pierre-muth/fast-flipdot/README.md

# fast-flipdot
Driving a flipdot matrix differently. All dots simultaneously. 
story here : https://pierremuth.wordpress.com/2021/02/17/flipping-dots-fast/
video here : https://youtu.be/6l5hH8V9uUo

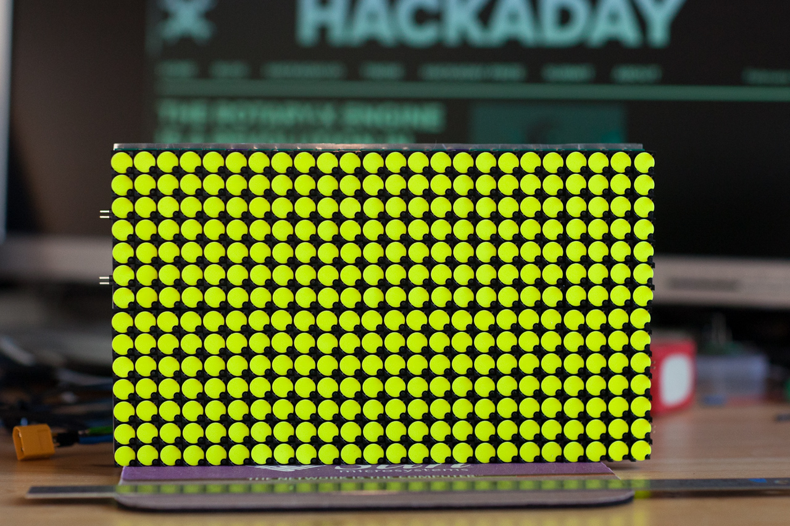
[picture p1: IMG_7713.jpg]
matrix
