pierre-muth/fast-flipdot/kicad/dot_flipper/dot.png

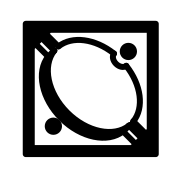
kicad/dot_flipper/dot.png
