pierre-muth/fast-flipdot/kicad/FlipDot-Mase.png

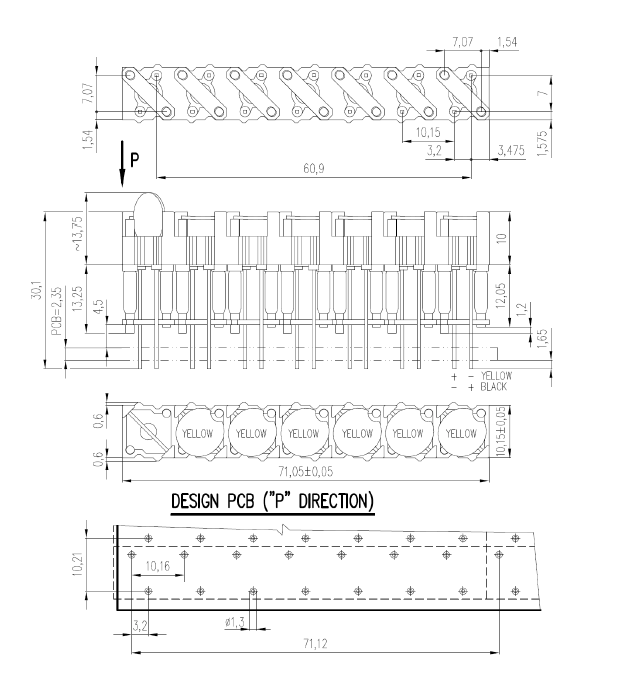
kicad/FlipDot-Mase.png
