pierre-muth/fast-flipdot/kicad/dot_flipper/dot_flipper.step

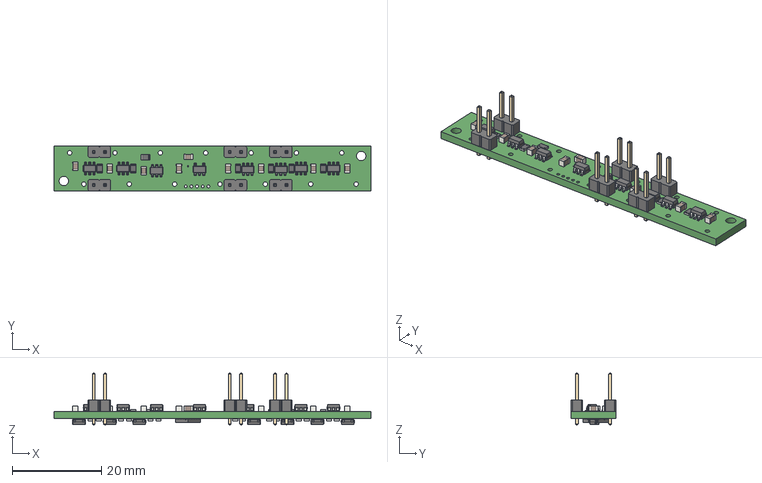
[picture p4: CAD file, 2021-02-18]
kicad/dot_flipper/dot_flipper.step
71.0 x 10.0 x 11.5 mm
