pierre-muth/fast-flipdot/(threads)

Thread 1 (2021-02-22):

Where to place the free-wheel diode ?

anybuche, 2021-02-22:
Hi,

I'm interested to push your design further, I see the used regulator can handle -20V to +38V so I guess it is already the more robust one. However it is unclear to me where you placed the free-wheel diode ? I would put it once per board between GND and 12V but wanted to ask for confirmation.

Thanks for your help

pierre-muth, 2021-02-22:
Hi !
Sorry it was unclear.
Yes, the microchip regulator is the more robust one, I didn't have any problem any more.
I only place one reverse diode between the main power connection. Not on all the boards. Apparently it is sufficient to absorb a negative pulse, which rarely appears when I disconnect the battery. Anyway the new regulators can handle it.
Sorry for the markings as well. It barely work with 12V, prefer at least 16V. In my setup I used a 4S lipo, but it's ideally 24V.
It is good you're asking questions, I realize I forgot quite some info.
For example, the capacitors should have the lowest resistance possible. Keep the 1210 package, as the 0805 will not work. Also, I stacked 2x 10uF for this reason.
I'm looking forward to see your design ! I'm sure mine can be greatly enhanced.
Anyway, don't hesitate!

Thread 2 (2021-11-06):

Two small schematic questions

dot4qu, 2021-11-06:
Hi Pierre,

Great design. I have a couple questions that I think are obvious but I want to double check
This is a screenshot of the basic components for each flip dot
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

1. Why have a second N-channel FET in front of the P-channel FET for FLIP_A_ON? Is it because you don't want to sink any current at that GPIO when the the pin is low? I ask because 12V / 100k = ~120uA and I'd assume the GPIO can sink in the 10s of mA no? I agree your design is more robust, but just a thought based on part count.
2. Any specific reason why you're using two separate pins for off and on instead of one and inverting the logic? Something like this:
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

pierre-muth, 2021-11-06:
Hi Brian,
Thanks for the questions and ideas!
The 12v potential on the schematics should be between 16 to 20v to have a better flipping. 12V works but is the lower limit.
I think I cannot sink 16v to ground with the PIC microcontroller.
In your schematics, R3 should be rather high to not blow Q2. This will prevent rapid discharge of C1 if I'm not wrong. In order to have the disc flipping, a high current should be able to flow through the coil, in both directions. The aim is to magnetize the core in one way or an other. So we have to maximize the current that charge the capacitor to flip in one way, and also maximize the discharge current to flip the other way.
Having two separate pins for ON and OFF (or flip one way, flip the other way) also makes possible to have a low consumption rest state.
Hope that make sense. Of course I'm sure I didn't make the more efficient design. It would be nice to reduce the parts count, but it was not my purpose. Commercial flipdot driver boards use source/sink matrices, and they are quite efficient.
Have a nice day, and don't hesitate,
pierre

dot4qu, 2021-11-12:
Isn't Q2 similar to Q1A in your schematic though? And your Q1A is shorted straight to ground so that's going to have a higher current across than Q2 would with R3 in series. So if Q1A works with the current of a full capacitor discharge to ground, I'd imagine a similar part could handle the current created from R3 when when Q2 is turned on to charge the capacitor. Am I understanding that correctly?

Otherwise yes, I totally understand that it only saves a single FET on the BOM which at these quantities is basically pointless. I'm just trying to better understand if what I have is equivalent in function.

pierre-muth, 2021-11-12:
To flip the disc to a position, a current has to flow few milliseconds through the coil, in order to magnetize the core in one direction.
If I'm following correctly your schematic, a signal on FLIP_A that goes from 0 to 5v will charge the capacitor, and flip the disc from back to yellow. Then, if FLIP_A goes back from 5v to 0v, the capacitor is discharged, and the disc flip back from yellow to black.
For the discharge to be efficient, R3 should be low. Is to keep the disc on the yellow side, current should constantly flow through R3? If you multiply this by 100's of disc, it will be a lot of current.
I could wrong of course. I made a lot of tests with one disc and a breadboard. Maybe you can try different strategies as well, I'm very interested in a solution uses less gpio and parts!

dot4qu, 2021-11-13:
Yes, all completely correct. I was making the mistake of forgetting that the whole point of flip-dots is to flip a hole bunch of them! You're right, it would burn current while Q2 stayed on after charging the capacitor and I completely forgot to multiply that by a large amount of dots. So for now it seems like your circuit definitely is the correct way to go. Thanks for the quick responses!

Closed 2021-11-13.

Thread 5 (2023-03-31):

Simulation : current on discharge

seigel, 2023-03-31:
I’m staring at the design, and I know from watching the breakfast vids that it works but I don’t understand how the current flows through the coil(inductor) when the charged side of the cap is connected to Gnd.  Anyone know of a spice or other sim I could watch or play with. Or if someone could dumb it down for me. :)
