pierre-muth/fast-flipdot/kicad/dot_flipper/Untitled.pdf

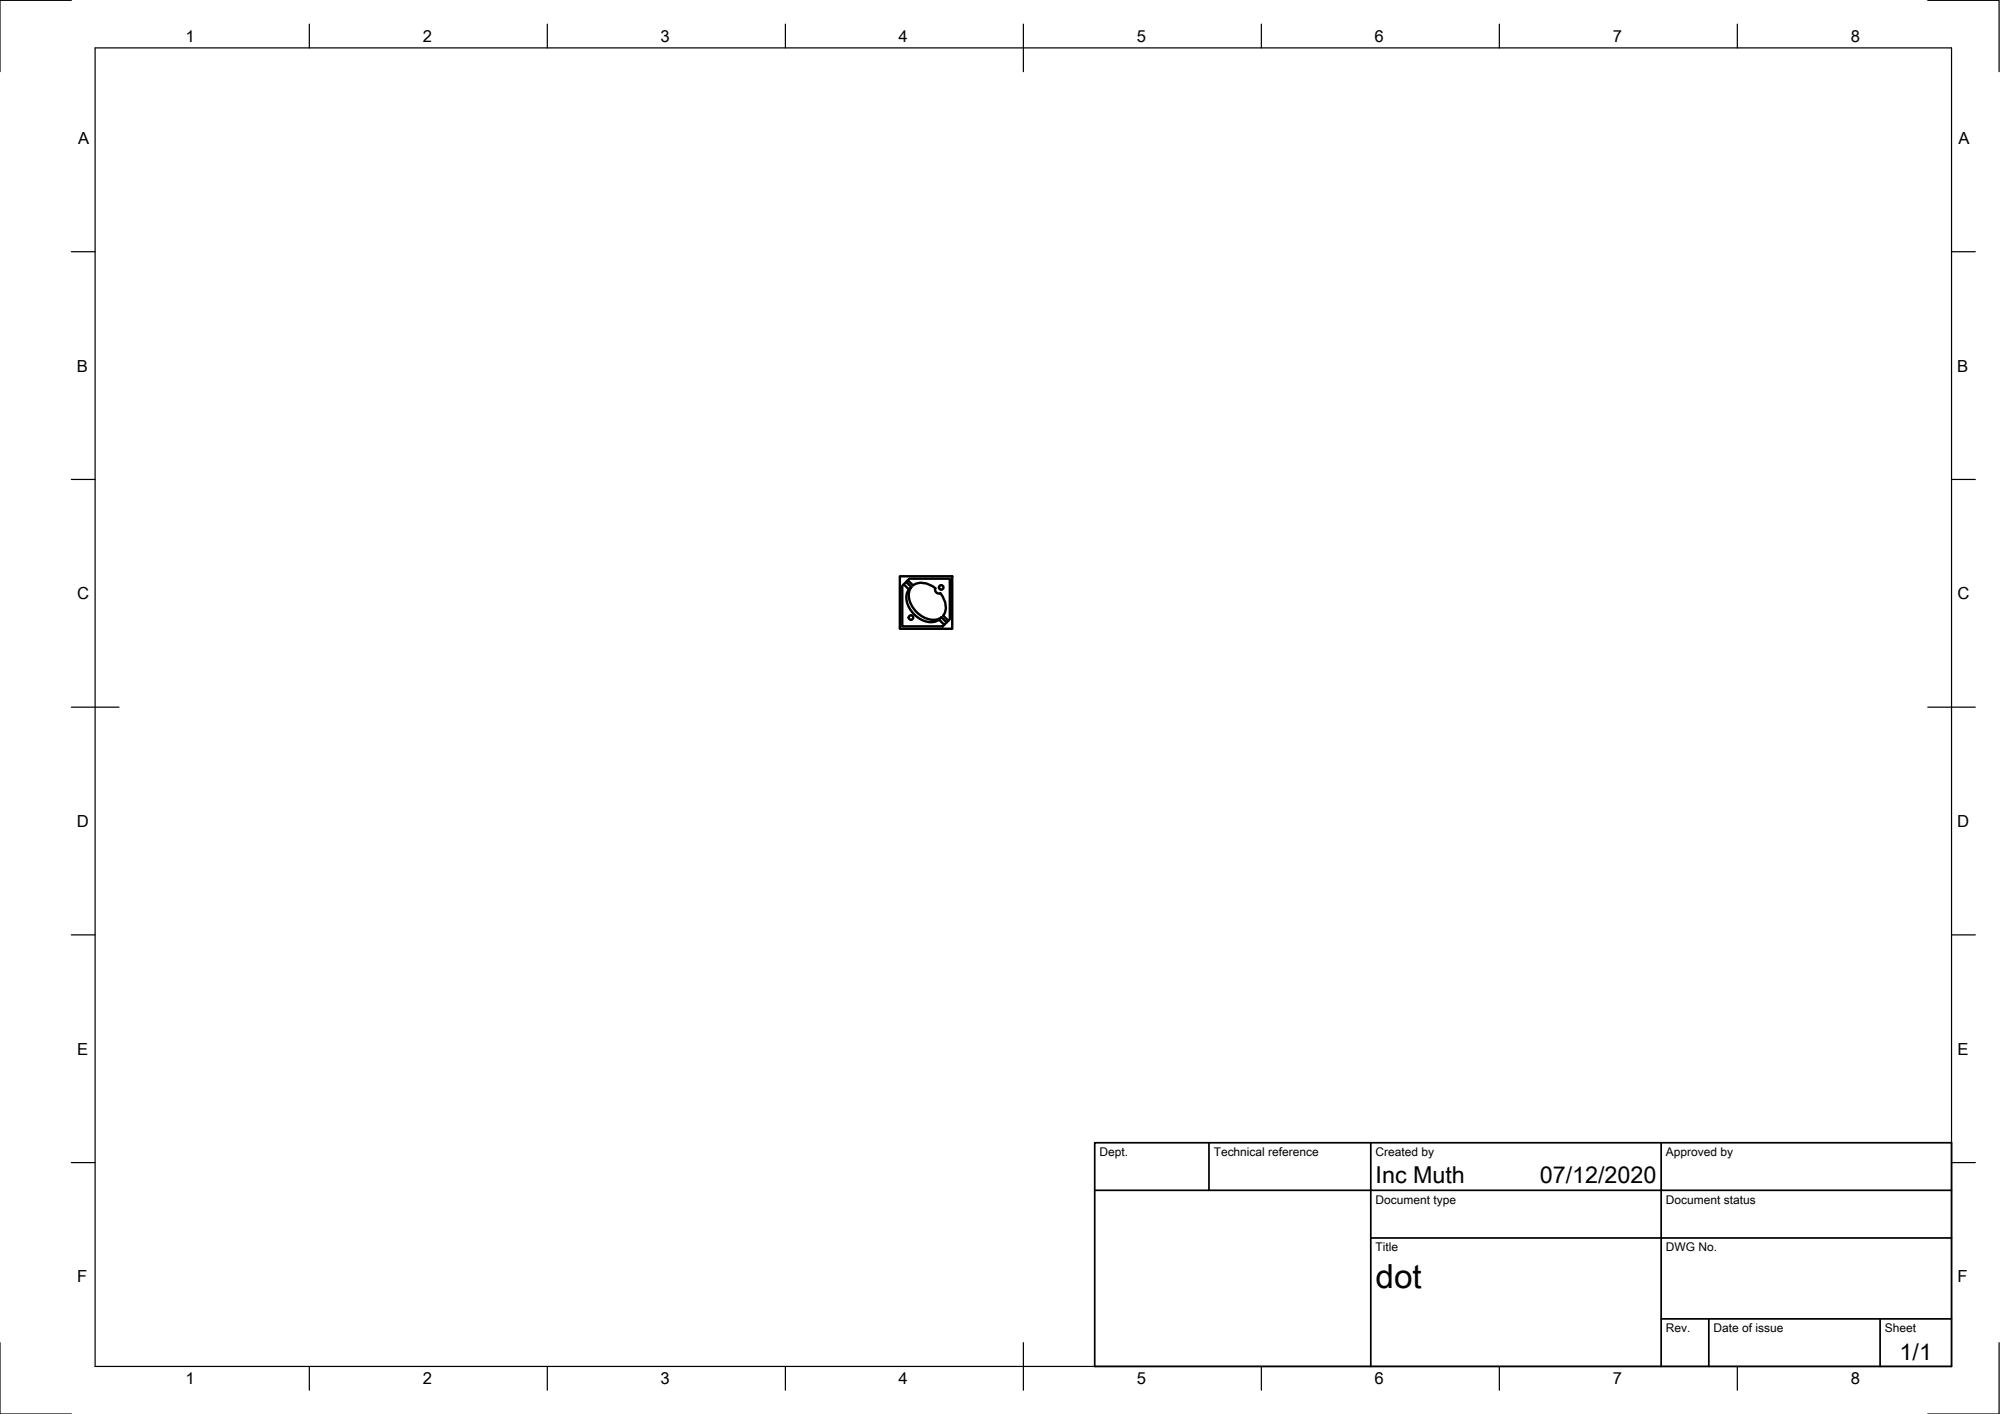
[picture p5: page 1]

Dept. | Technical reference | Created by Inc Muth 07/12/2020 | Approved by

Document type | Document status

Title dot | DWG No.

Rev. | Date of issue | Sheet 1/1
