pierre-muth/fast-flipdot/kicad/dot_flipper/pdf/dot_flipper-B_Cu.pdf

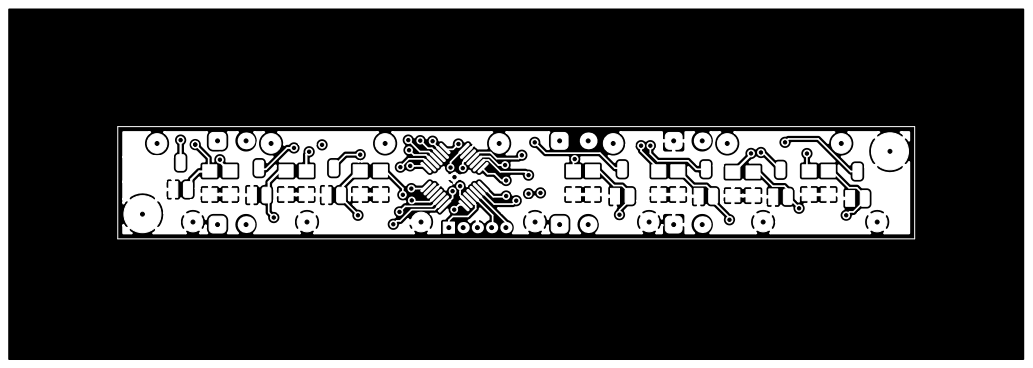
[picture p6: page 1]
