pierre-muth/fast-flipdot/kicad/dot_flipper/pdf/dot_flipper-F_Cu.pdf

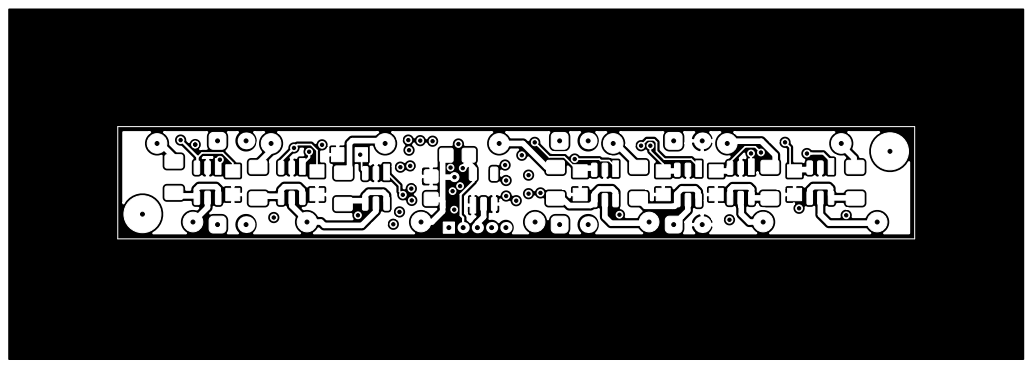
[picture p7: page 1]
