pierre-muth/fast-flipdot/kicad/dot_flipper/pdf/dot_flipper-In1_Cu.pdf

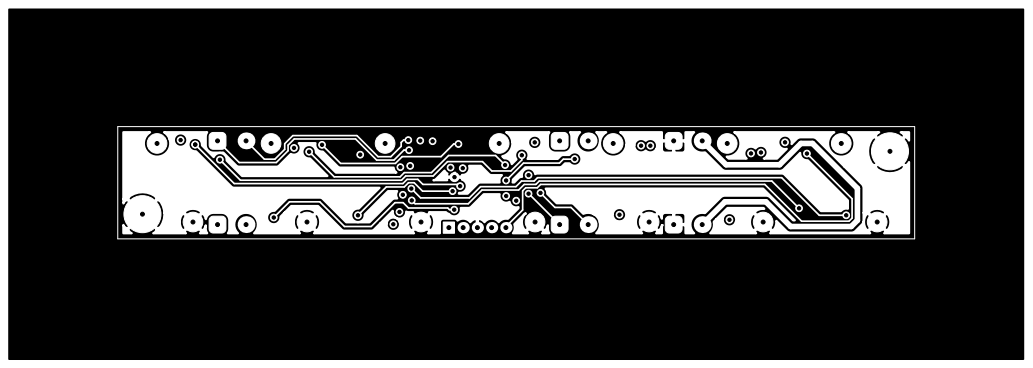
[picture p8: page 1]
