pierre-muth/fast-flipdot/kicad/dot_flipper/pdf/dot_flipper-In2_Cu.pdf

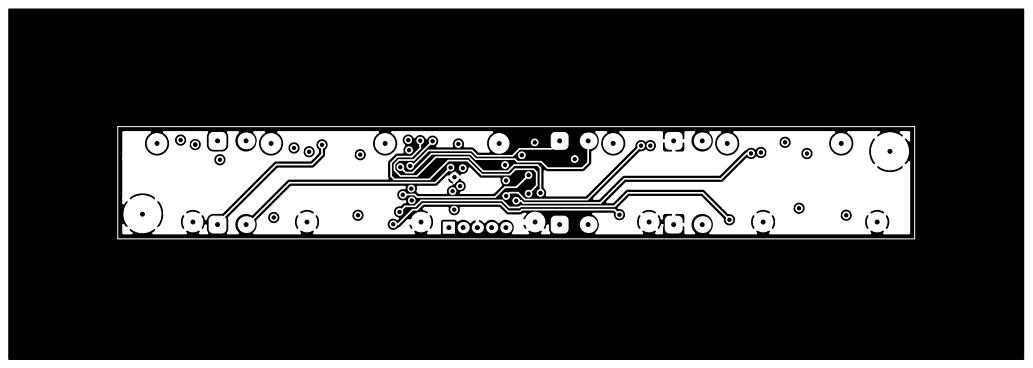
[picture p9: page 1]
