pierre-muth/fast-flipdot/kicad/dot_flipper/pdf/dot_flipper.pdf

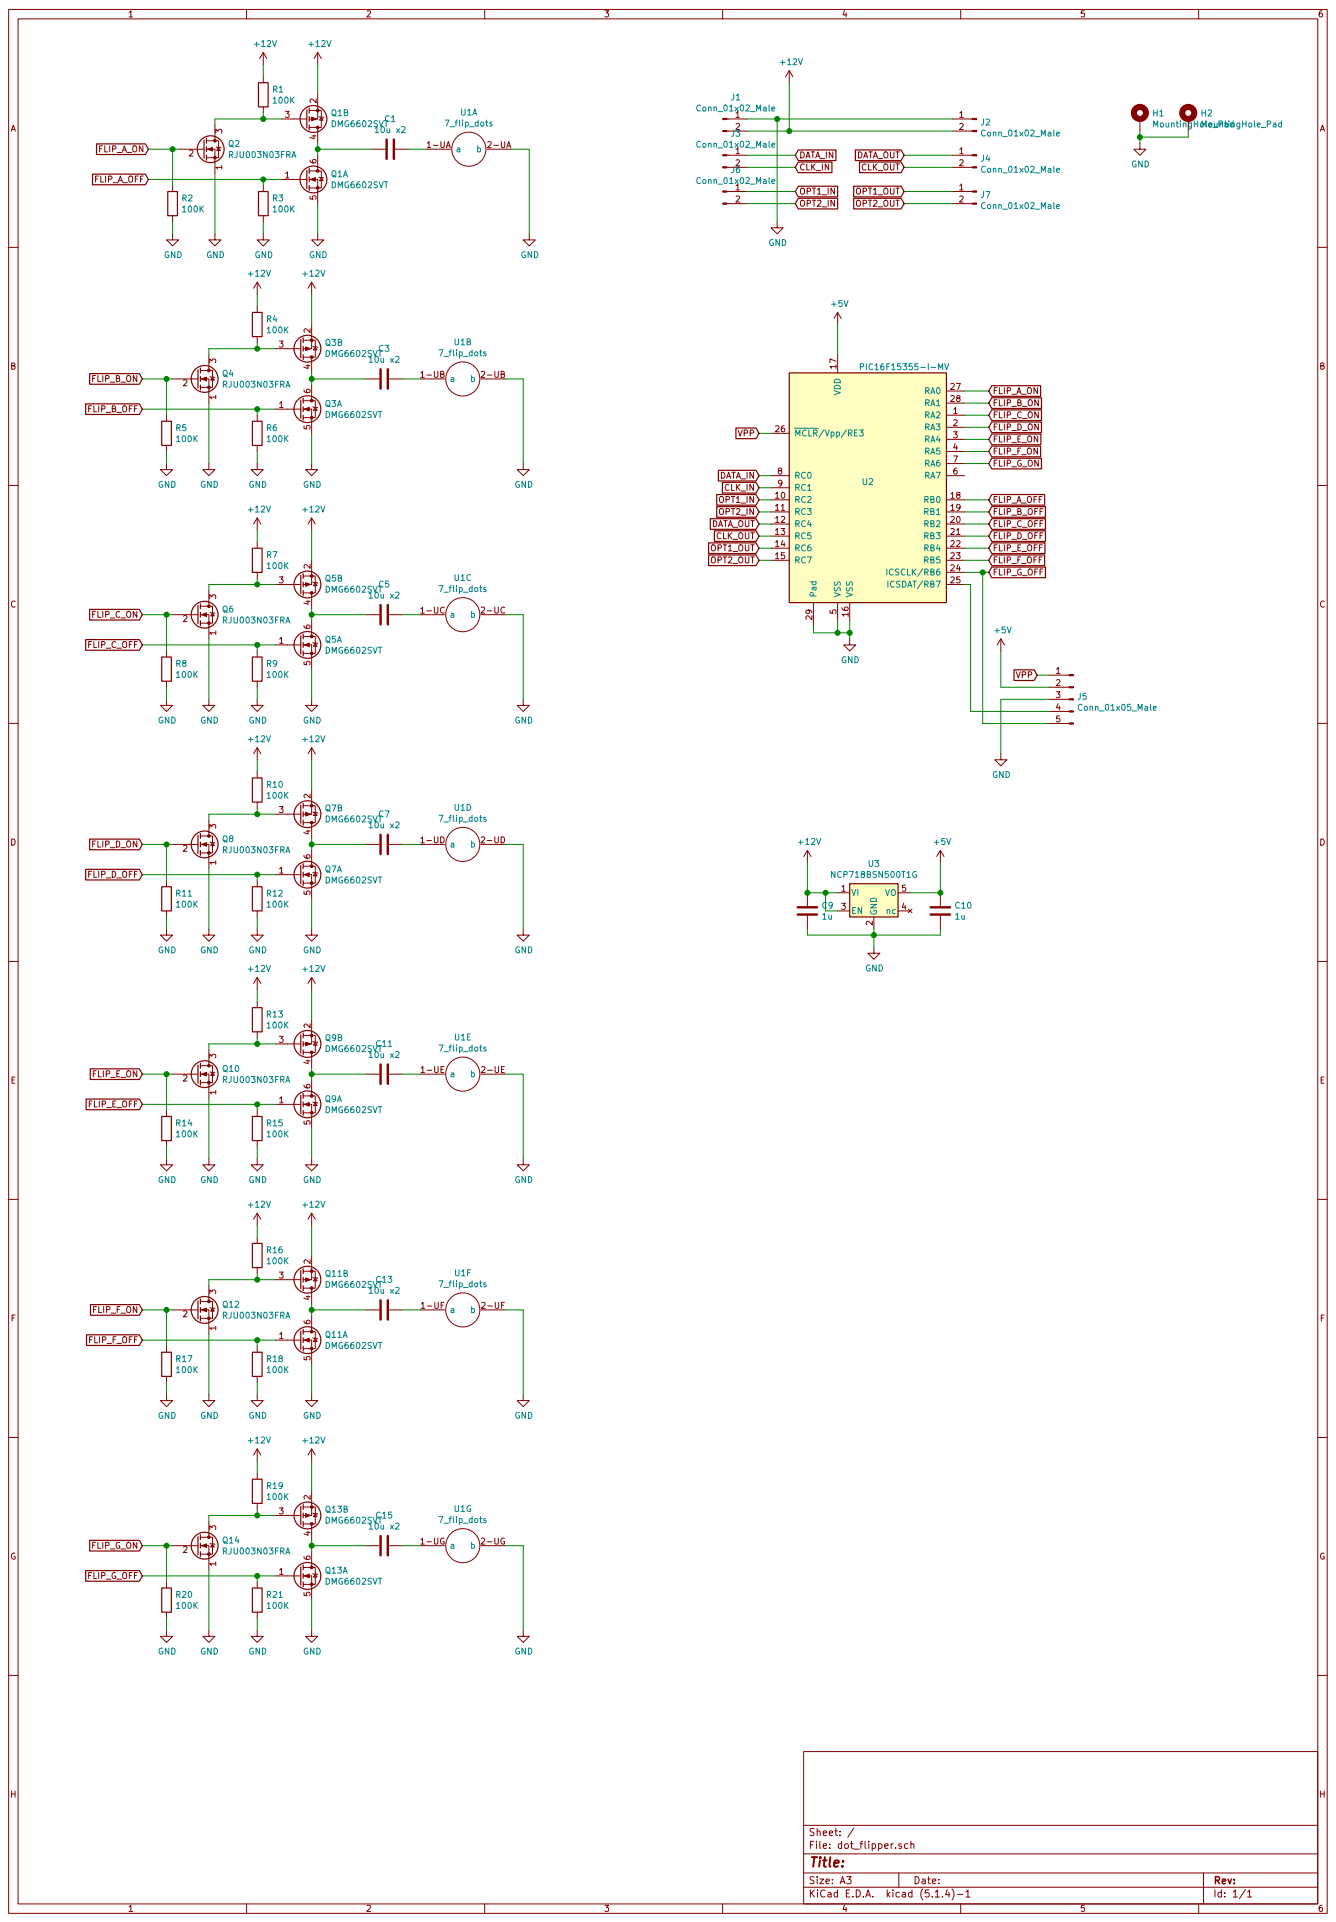
[picture p10: page 1]
