pierre-muth/fast-flipdot/(list of files, drawings)

Other design files:
kicad/dot_flipper/dot_flipper.dsn
kicad/dot_flipper/dot_flipper_4l.dsn
