pierre-muth/fast-flipdot/kicad/dot_flipper/dot_flipper.kicad_pcb

## KiCad design kicad/dot_flipper/dot_flipper.kicad_pcb (2021-02-18)

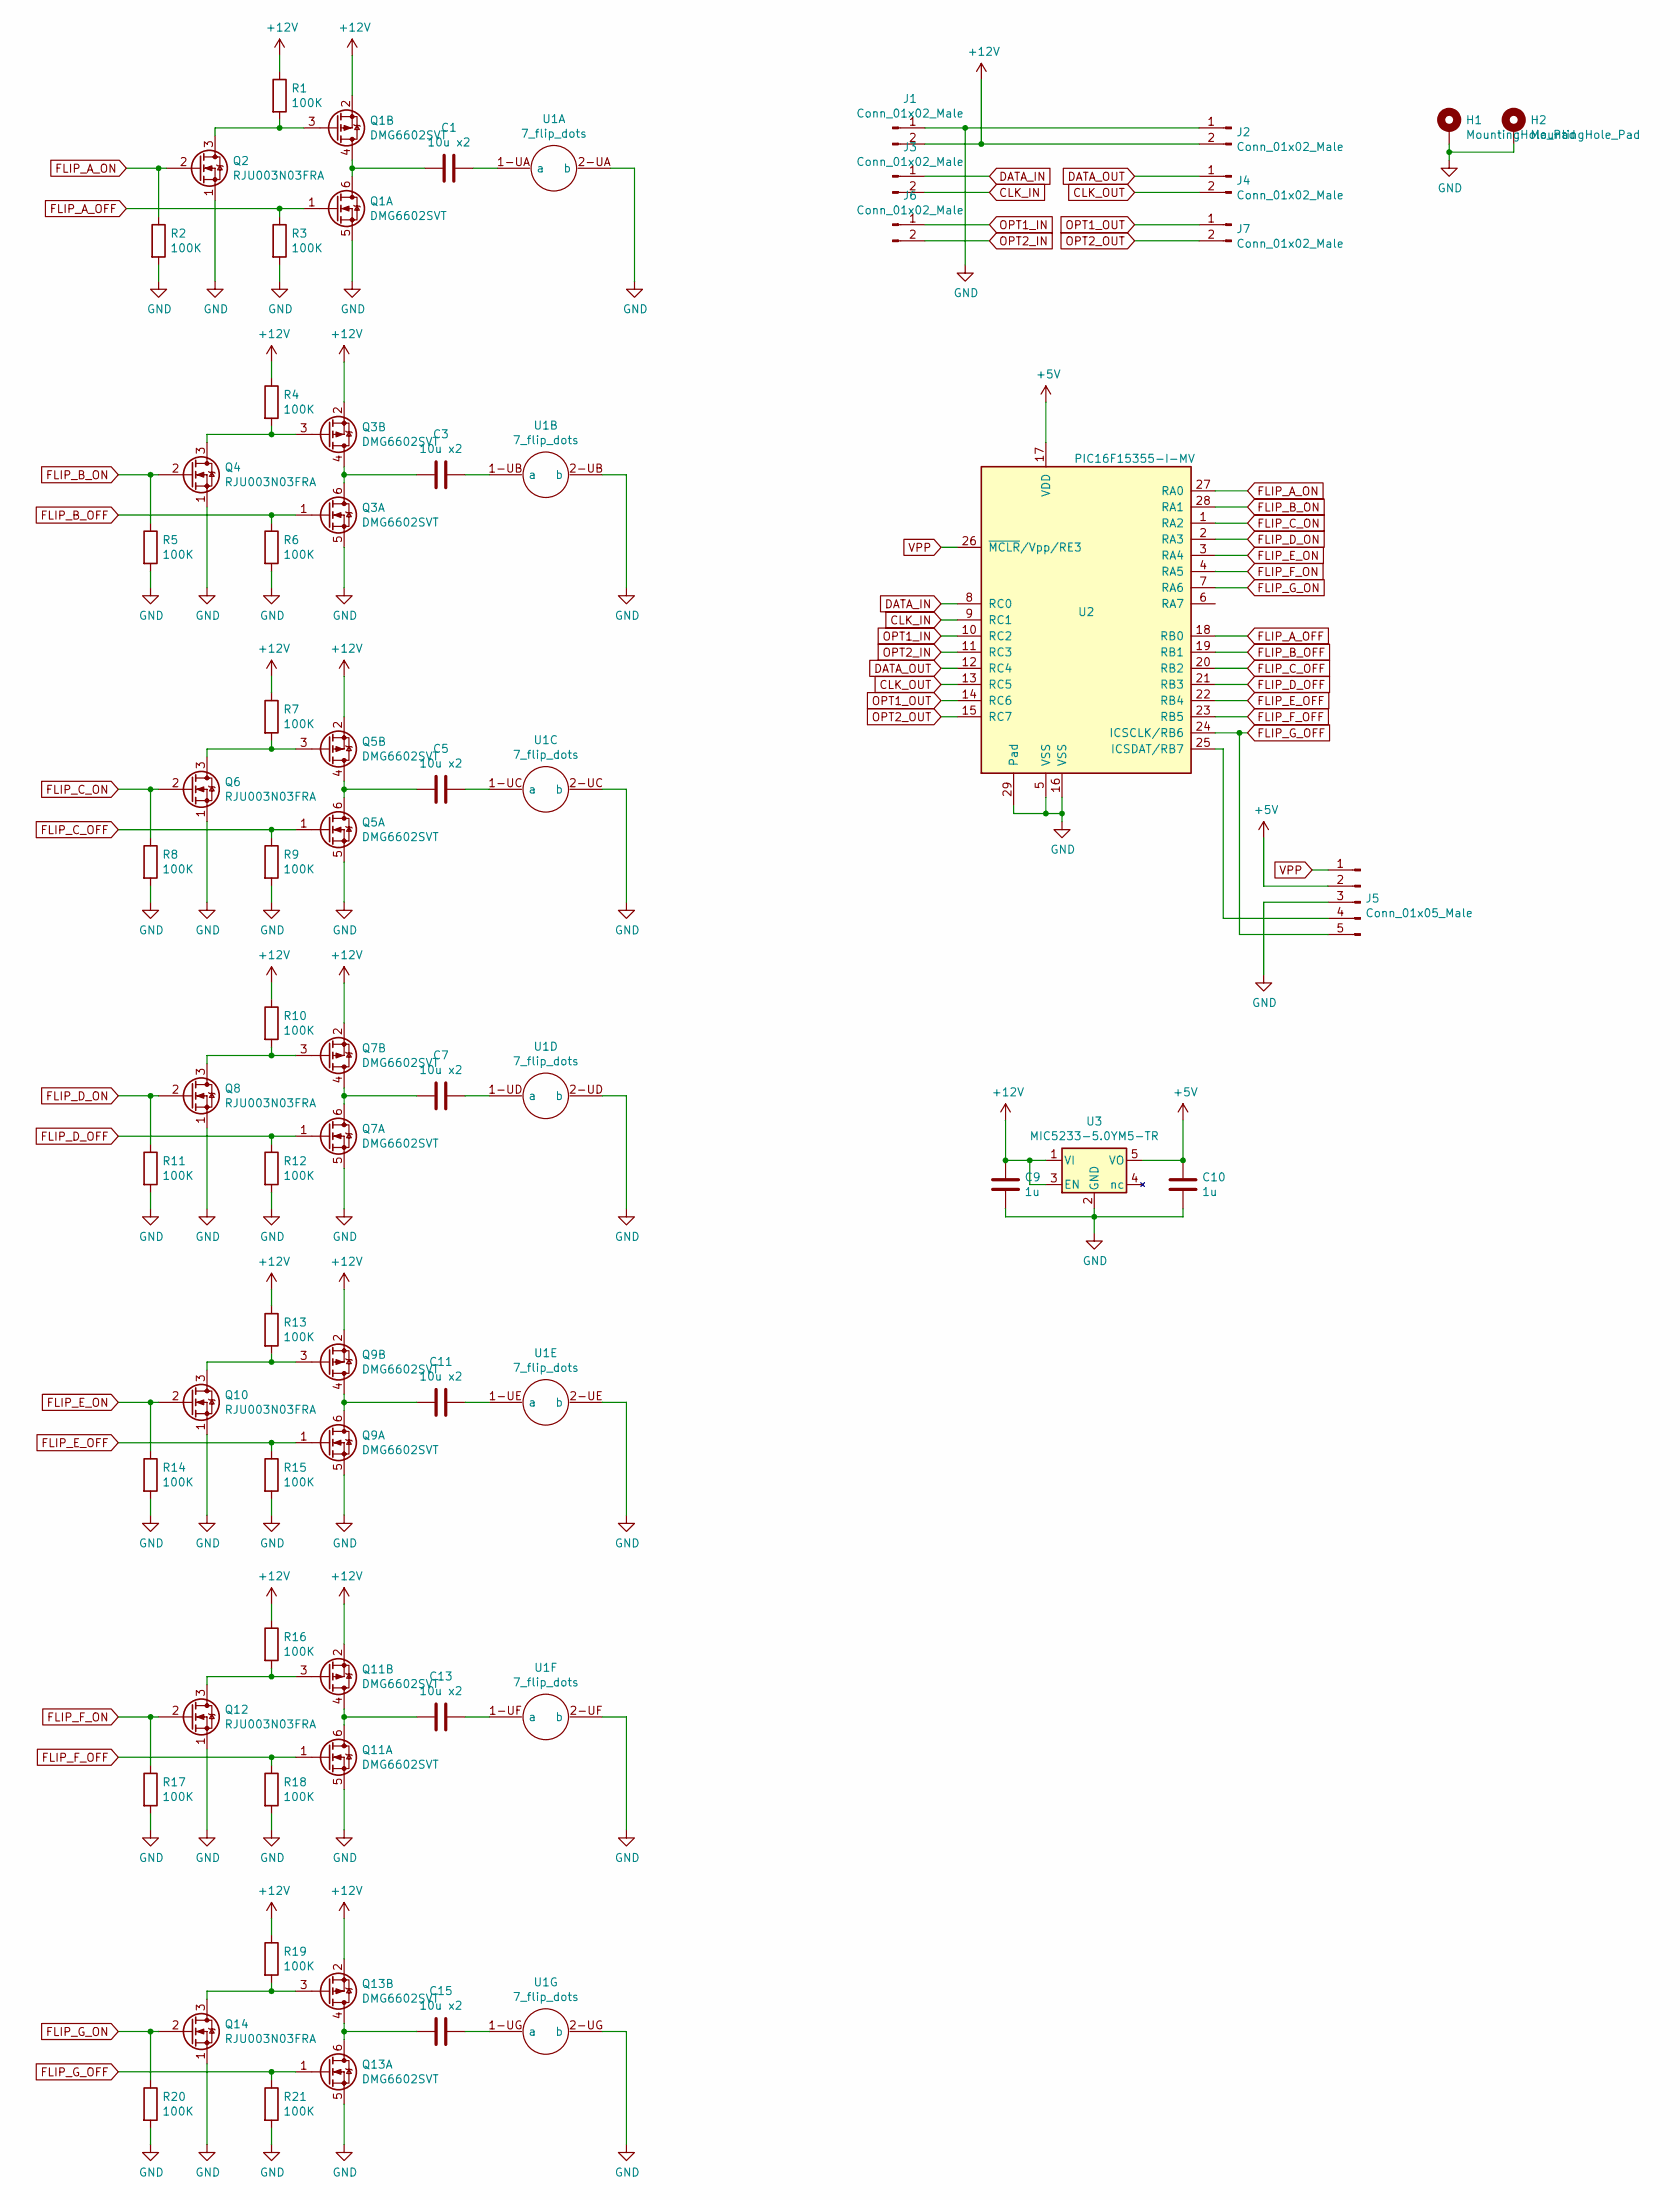
[picture p11: schematic dot_flipper.sch]

Parts:
C1, C3, C5, C7, C11, C13, C15: 10u x2; C_1206
C9, C10: 1u; C_0805
H1, H2: MountingHole_Pad; MountingHole_2.2mm_M2_Pad_thin
J1, J2, J3, J4, J6, J7: Conn_01x02_Male; Pin_Header_Straight_1x02_Pitch2.54mm
J5: Conn_01x05_Male; Pin_Header_Straight_1x05_Pitch1.27mm
Q1, Q3, Q5, Q7, Q9, Q11, Q13: DMG6602SVT; SOT-23-6_Handsoldering
Q2, Q4, Q6, Q8, Q10, Q12, Q14: RJU003N03FRA; SOT-23-small
R1, R2, R3, R4, R5, R6, R7, R8, R9, R10, R11, R12, R13, R14, R15, R16, R17, R18, R19, R20, R21: 100K; R_0805
U1: 7_flip_dots
U2: PIC16F15355-I-MV; QFN-28-1EP_4x4mm_Pitch0.4mm_wide
U3: MIC5233-5.0YM5-TR; SOT-23-5_HandSoldering

Connections:
+5V: C10.1, J5.2, U2.17 (VDD), U3.5 (VO)
+12V: C9.1, J1.2, J2.2, Q1.2 (S), Q3.2 (S), Q5.2 (S), Q7.2 (S), Q9.2 (S), Q11.2 (S), Q13.2 (S), R1.1, R4.1, R7.1, R10.1, R13.1, R16.1, R19.1, U3.1 (VI), U3.3 (EN)
CLK_IN: J3.2, U2.9 (RC1)
CLK_OUT: J4.2, U2.13 (RC5)
DATA_IN: J3.1, U2.8 (RC0)
DATA_OUT: J4.1, U2.12 (RC4)
FLIP_A_OFF: Q1.1 (G), R3.1, U2.18 (RB0)
FLIP_A_ON: Q2.2 (G), R2.1, U2.27 (RA0)
FLIP_B_OFF: Q3.1 (G), R6.1, U2.19 (RB1)
FLIP_B_ON: Q4.2 (G), R5.1, U2.28 (RA1)
FLIP_C_OFF: Q5.1 (G), R9.1, U2.20 (RB2)
FLIP_C_ON: Q6.2 (G), R8.1, U2.1 (RA2)
FLIP_D_OFF: Q7.1 (G), R12.1, U2.21 (RB3)
FLIP_D_ON: Q8.2 (G), R11.1, U2.2 (RA3)
FLIP_E_OFF: Q9.1 (G), R15.1, U2.22 (RB4)
FLIP_E_ON: Q10.2 (G), R14.1, U2.3 (RA4)
FLIP_F_OFF: Q11.1 (G), R18.1, U2.23 (RB5)
FLIP_F_ON: Q12.2 (G), R17.1, U2.4 (RA5)
FLIP_G_OFF: J5.5, Q13.1 (G), R21.1, U2.24 (ICSCLK/RB6)
FLIP_G_ON: Q14.2 (G), R20.1, U2.7 (RA6)
GND: C9.2, C10.2, H1.1, H2.1, J1.1, J2.1, J5.3, Q1.5 (S), Q2.1 (S), Q3.5 (S), Q4.1 (S), Q5.5 (S), Q6.1 (S), Q7.5 (S), Q8.1 (S), Q9.5 (S), Q10.1 (S), Q11.5 (S), Q12.1 (S), Q13.5 (S), Q14.1 (S), R2.2, R3.2, R5.2, R6.2, R8.2, R9.2, R11.2, R12.2, R14.2, R15.2, R17.2, R18.2, R20.2, R21.2, U1.2-UA (b), U1.2-UB (b), U1.2-UC (b), U1.2-UD (b), U1.2-UE (b), U1.2-UF (b), U1.2-UG (b), U2.5 (VSS), U2.16 (VSS), U2.29 (Pad), U3.2 (GND)
unnamed: C1.1, U1.1-UA (a)
unnamed: C1.2, Q1.4 (D), Q1.6 (D)
unnamed: C3.1, U1.1-UB (a)
unnamed: C3.2, Q3.4 (D), Q3.6 (D)
unnamed: C5.1, U1.1-UC (a)
unnamed: C5.2, Q5.4 (D), Q5.6 (D)
unnamed: C7.1, U1.1-UD (a)
unnamed: C7.2, Q7.4 (D), Q7.6 (D)
unnamed: C11.1, U1.1-UE (a)
unnamed: C11.2, Q9.4 (D), Q9.6 (D)
unnamed: C13.1, U1.1-UF (a)
unnamed: C13.2, Q11.4 (D), Q11.6 (D)
unnamed: C15.1, U1.1-UG (a)
unnamed: C15.2, Q13.4 (D), Q13.6 (D)
unnamed: J5.4, U2.25 (ICSDAT/RB7)
unnamed: Q1.3 (G), Q2.3 (D), R1.2
unnamed: Q3.3 (G), Q4.3 (D), R4.2
unnamed: Q5.3 (G), Q6.3 (D), R7.2
unnamed: Q7.3 (G), Q8.3 (D), R10.2
unnamed: Q9.3 (G), Q10.3 (D), R13.2
unnamed: Q11.3 (G), Q12.3 (D), R16.2
unnamed: Q13.3 (G), Q14.3 (D), R19.2
OPT1_IN: J6.1, U2.10 (RC2)
OPT1_OUT: J7.1, U2.14 (RC6)
OPT2_IN: J6.2, U2.11 (RC3)
OPT2_OUT: J7.2, U2.15 (RC7)
VPP: J5.1, U2.26 (~MCLR~/Vpp/RE3)

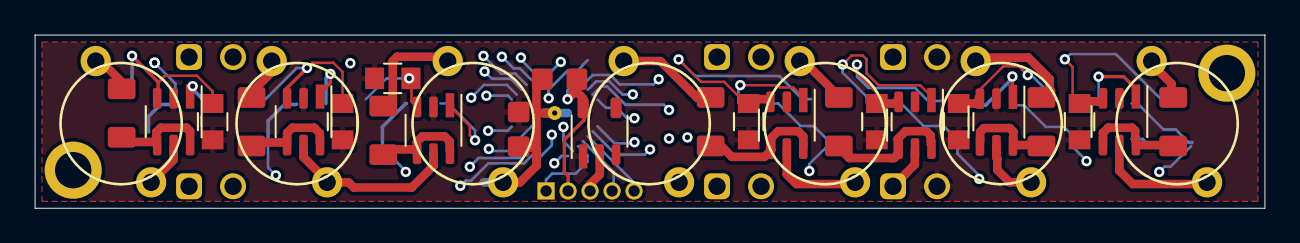
[picture p12: board dot_flipper.kicad_pcb from above]

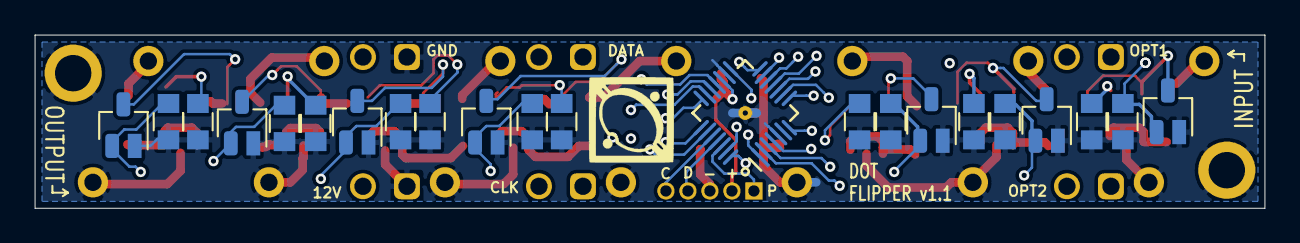
[picture p13: board dot_flipper.kicad_pcb from below]

Board: 4 copper layers, 71.0 x 10.0 mm, 56 parts (22 on the bottom side), 48 nets.
