pierre-muth/fast-flipdot/(commit log)

2021-02-18 upload kicad files
    [001_dot_flipper.kicad_pcb, 002_dot_flipper.kicad_pcb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]
2021-02-18 upload ESP32 code
